rookies/shotbot/cad/button.FCStd

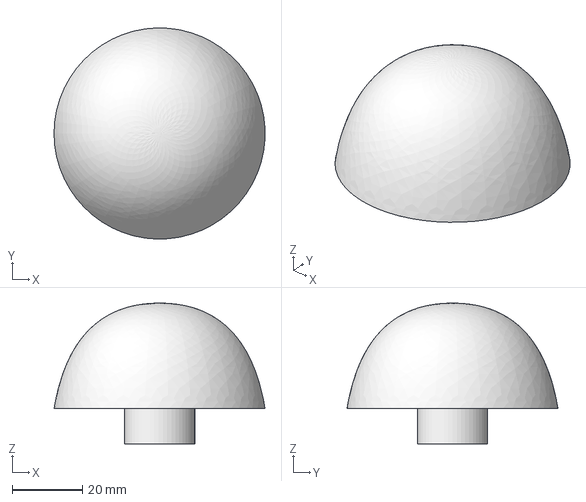
[picture p1: CAD file, 2022-07-09]
cad/button.FCStd
60.0 x 60.0 x 40.0 mm
