rookies/shotbot/cad/ws2812_holder.FCStd

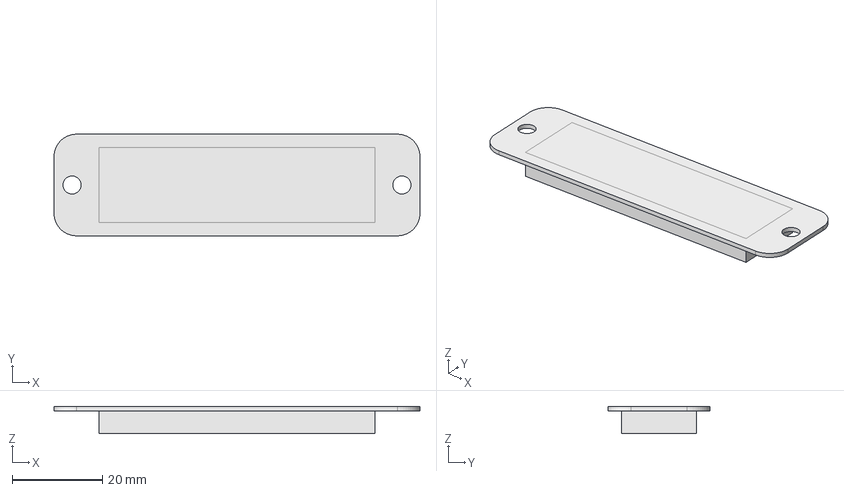
[picture p2: CAD file, 2021-10-14]
cad/ws2812_holder.FCStd
81.0 x 22.5 x 6.00 mm
