rookies/shotbot/pcb/shotbot.kicad_pcb

## KiCad design pcb/shotbot.kicad_pcb (2020-11-10)

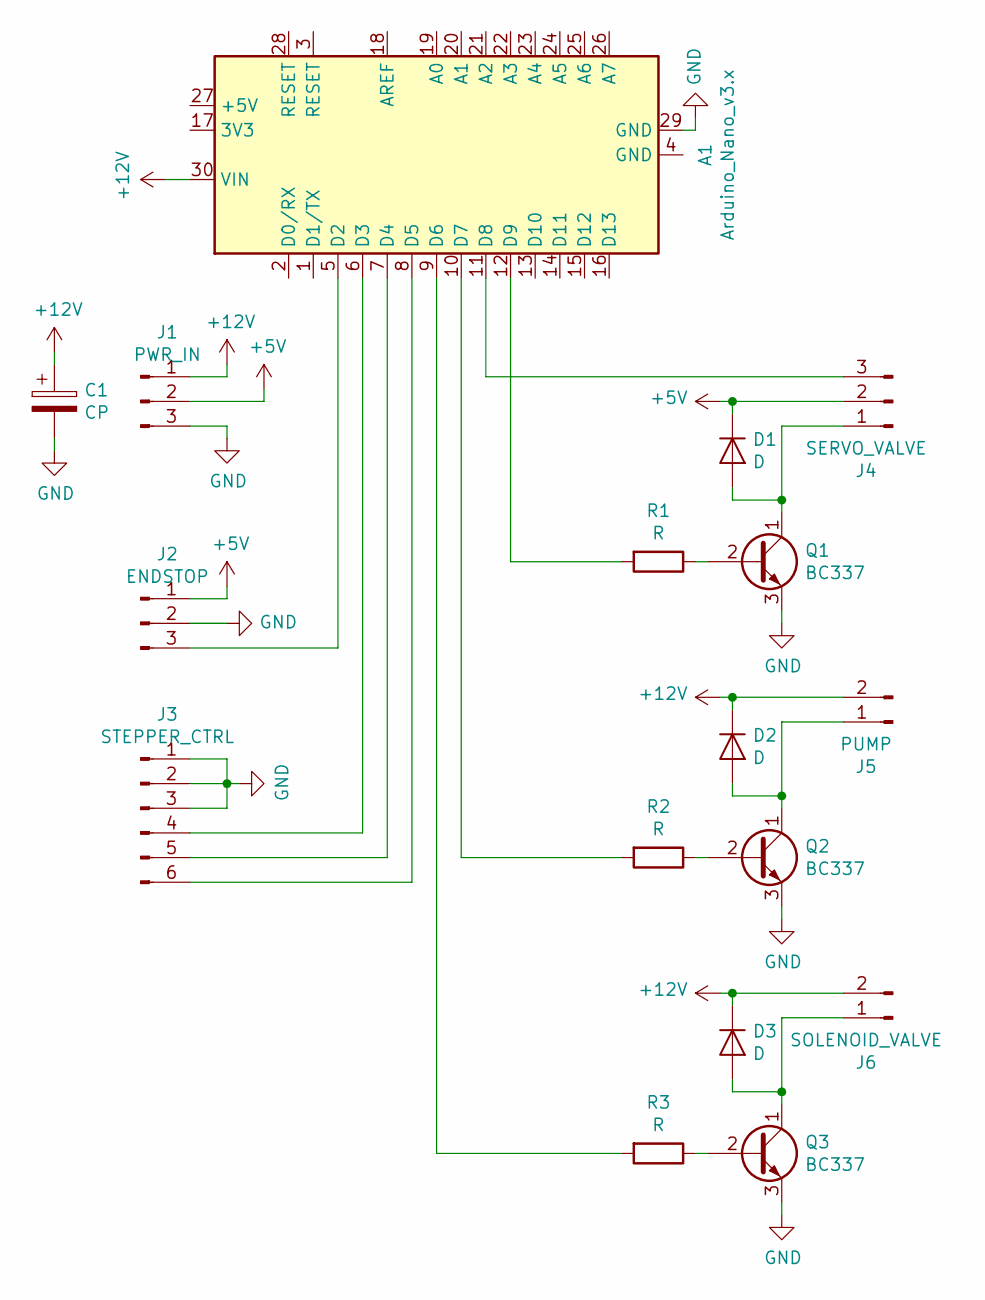
[picture p3: schematic shotbot.sch]

Parts:
A1: Arduino_Nano_v3.x; Arduino_Nano
C1: CP; CP_Radial_D8.0mm_P5.00mm
D1, D2, D3: D; D_DO-15_P2.54mm_Vertical_AnodeUp
J1: PWR_IN; PinHeader_1x03_P2.54mm_Vertical
J2: ENDSTOP; PinHeader_1x03_P2.54mm_Vertical
J3: STEPPER_CTRL; PinHeader_1x06_P2.54mm_Vertical
J4: SERVO_VALVE; PinHeader_1x03_P2.54mm_Vertical
J5: PUMP; PinHeader_1x02_P2.54mm_Vertical
J6: SOLENOID_VALVE; PinHeader_1x02_P2.54mm_Vertical
Q1, Q2, Q3: BC337; TO-92_Inline_Wide
R1, R2, R3: R; R_Axial_DIN0207_L6.3mm_D2.5mm_P2.54mm_Vertical

Connections:
+5V: D1.1 (K), J1.2, J2.1, J4.2
+12V: A1.30 (VIN), C1.1, D2.1 (K), D3.1 (K), J1.1, J5.2, J6.2
GND: A1.29 (GND), C1.2, J1.3, J2.2, J3.1, J3.2, J3.3, Q1.3 (E), Q2.3 (E), Q3.3 (E)
unnamed: A1.5 (D2), J2.3
unnamed: A1.6 (D3), J3.4
unnamed: A1.7 (D4), J3.5
unnamed: A1.8 (D5), J3.6
unnamed: A1.9 (D6), R3.2
unnamed: A1.10 (D7), R2.2
unnamed: A1.11 (D8), J4.3
unnamed: A1.12 (D9), R1.2
unnamed: D1.2 (A), J4.1, Q1.1 (C)
unnamed: D2.2 (A), J5.1, Q2.1 (C)
unnamed: D3.2 (A), J6.1, Q3.1 (C)
unnamed: Q1.2 (B), R1.1
unnamed: Q2.2 (B), R2.1
unnamed: Q3.2 (B), R3.1

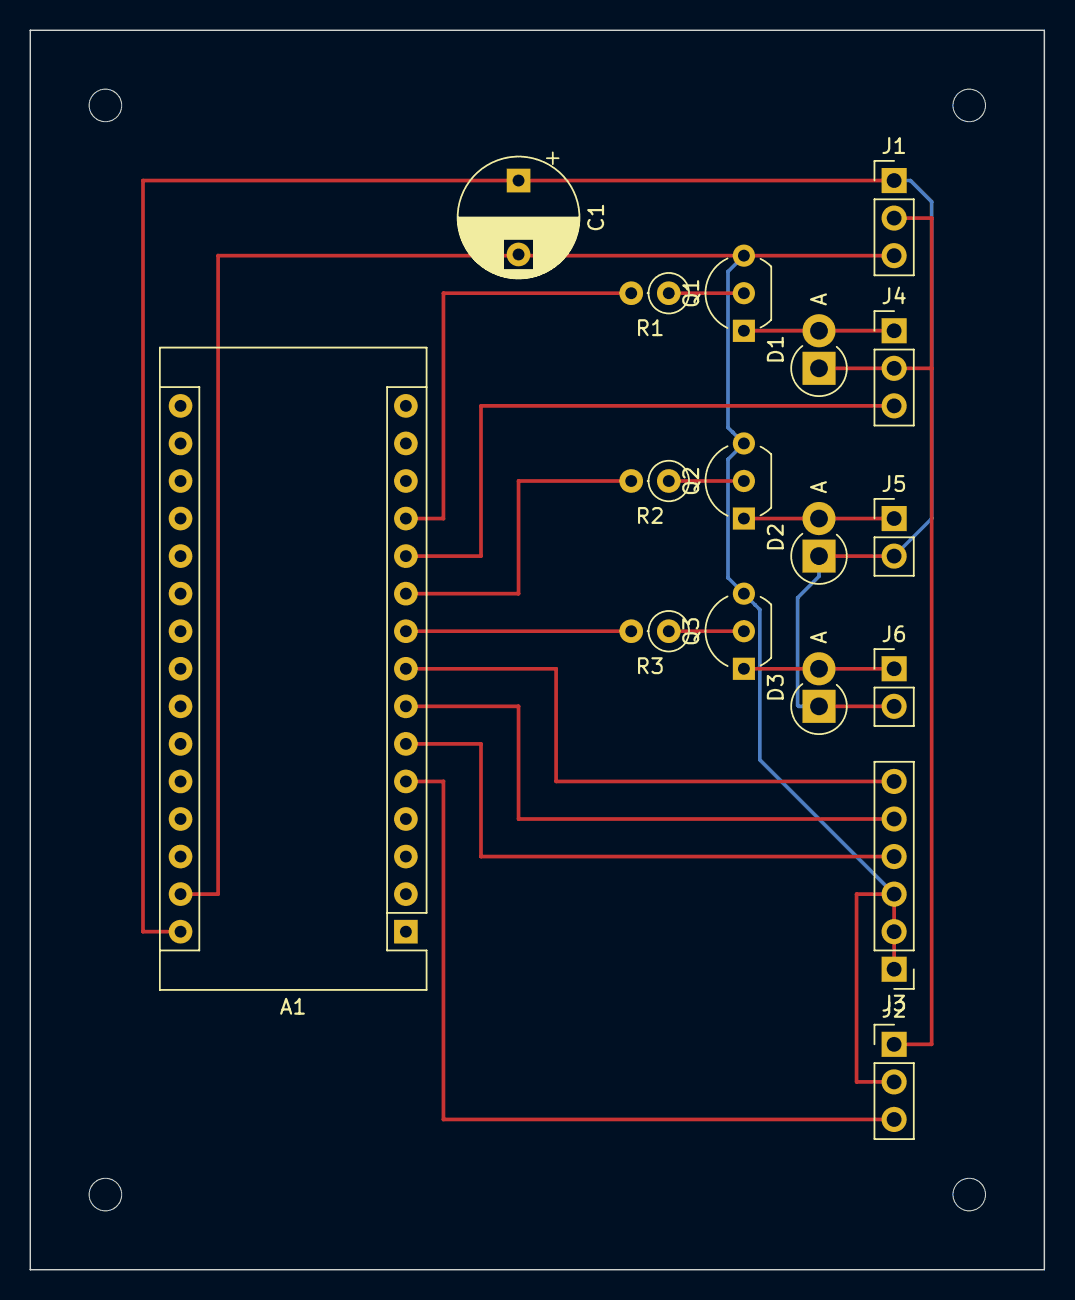
[picture p4: board shotbot.kicad_pcb from above]

Board: 2 copper layers, 68.6 x 83.8 mm, 17 parts (0 on the bottom side), 17 nets.
