rookies/shotbot/(commit log)

2019-09-19 implemeted stepper control over serial port
2019-09-19 small fix in serial interface
    [arduino-software.ino]
2019-09-22 suppress posreached for homing
2019-09-22 added endstop released message
2019-09-22 disabled auto-homing at startup
2019-09-24 arduino: implemented pump command
2019-09-24 serialtest.py: added pumping
2019-11-08 add valve control to the software
2019-11-09 add solenoid valve to electronics overview
2019-11-12 add solenoid and servo enable pin
2019-11-12 add current state to electronics overview
2019-11-13 add servo library to makefile
2019-11-15 use a thread to play music
2019-11-16 add task to close servo valve
2019-11-16 add task to switch off valve servo
2019-11-16 add task to close the solenoid valve
2019-11-16 arduino code cleanup
2019-11-16 clean up arduino config
2019-11-16 implement pumpMaxTime
2019-11-23 enable servo before closing the valve
2019-11-23 arduino code cleanup with new interface
    NOTE: not yet compatible with host software
2019-11-23 fix some problems with new interface
    [arduino-software.ino]
2019-11-23 implement valve and pump with new interface
2019-11-28 add CAD models
    [amplifier_holder.scad, leadscrew_carriage.scad, pcb_holder.scad, pcb_protector.scad, spacer.scad, switch_holder.scad]
2019-11-30 solenoid & tablet holder CAD
    [solenoid_holder.scad, tablet_holder.scad]
2020-06-06 ignore gcode, stl, 3mf
2020-06-06 tweak walve and pump time
2020-11-10 add PCB
    [shotbot.kicad_pcb, shotbot.sch]
2021-09-12 Switch to using peristaltic pumps
2021-09-12 Add selector knobs for count and pump
2021-09-12 Show selected count using LEDs
2021-09-12 Make LED color configurable
2021-09-12 Add start button
2021-09-13 Show selected pump using LEDs
2021-09-19 Move pump and stepper into own classes
2021-09-28 Switch to new stepper driver
2021-10-14 Add WS2812 holder
    [ws2812_holder.FCStd]
2021-10-14 Improve WS2812 holder
    [ws2812_holder.FCStd]
2021-10-22 Add pumpTime config option
2021-10-22 Reverse count LEDs
2021-10-22 Use four pumps
2022-07-09 Add button CAD model
    [button.FCStd]
